4x1md/hf_loop_ant/README.md

# HF Resonant Loop Antenna

## Overview

The antenna was built to be used for shortwave listening with a Tecsun PL-660 radio receiver. Later it was used with Yaesu VX-6 handheld transceiver and with Yaesu FT-817ND for shortwave listening. The antenna is mobile and sometimes I take it to SWL on the open air.

## Construction

The antenna is built of two copper tubes. The tube used in the large loop, which forms a resonant LC circuit, is 10 mm in diameter and about 125 cm long. The small tube, which is used for coupling to the radio, is made from a 8 mm in diameter and about 28 cm long. The loops are not connected between them.

The variable capacitor is from an old AM/FM radio receiver. It has five sections: three sections of 30 pF which were used for FM band and two of about 430 pF previously used for AM reception. One 30pF section is constantly connected to the big loop while the other four can be connected using three tumbler switches (two 30pF sections are connected together). Connecting different sections makes it possible to get different maximum capacities.

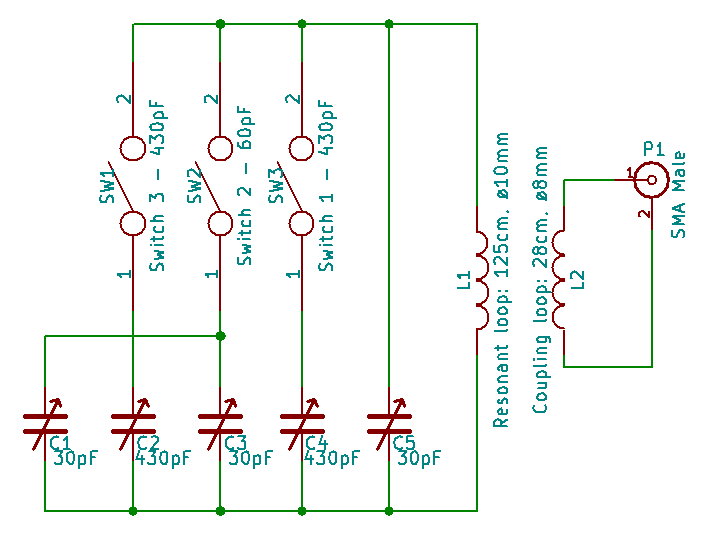
[picture p1: Images/hf_loop_schem.png]
HF Resonant Loop Schematics


## Performance

The antenna tunes from about 6.5MHz (all the capacitors connected and at are set to the full capacity) up to about 43MHz. This tuning range makes it suitable for shortwave listening on 10-40 meters bands. The antenna shows very narrow bandwidth and has to be adjusted when receiver frequency changes by about 20-30 KHz. The sensitivity is not always high and sometimes it is outperformed by a long (~10M) piece of wire.

I've never used it for transmitting because my current amateur radio license doesn't permit transmitting on HF bands.

## Photo Gallery

The first version was mounted on a plastic tube without any base to put it on.

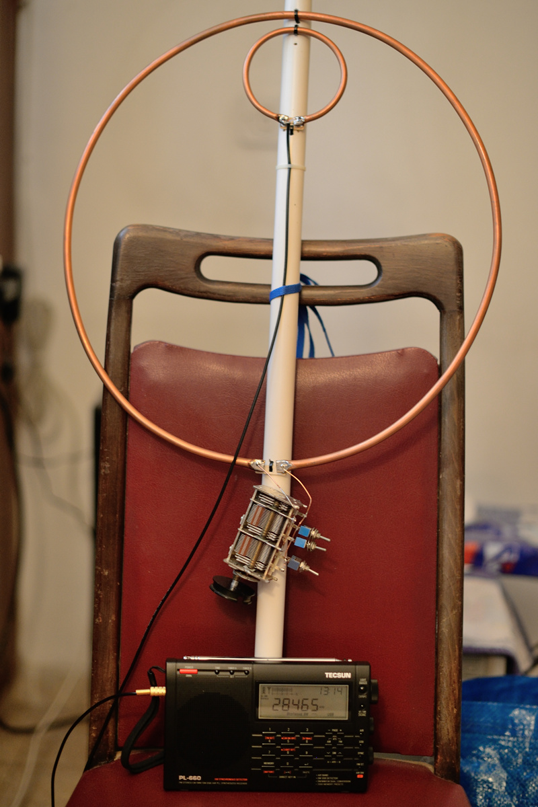
[picture p2: Images/hf_loop_01.jpg]
HF Resonant Loop


Metal tubes, variable capacitor and tumbler switches:

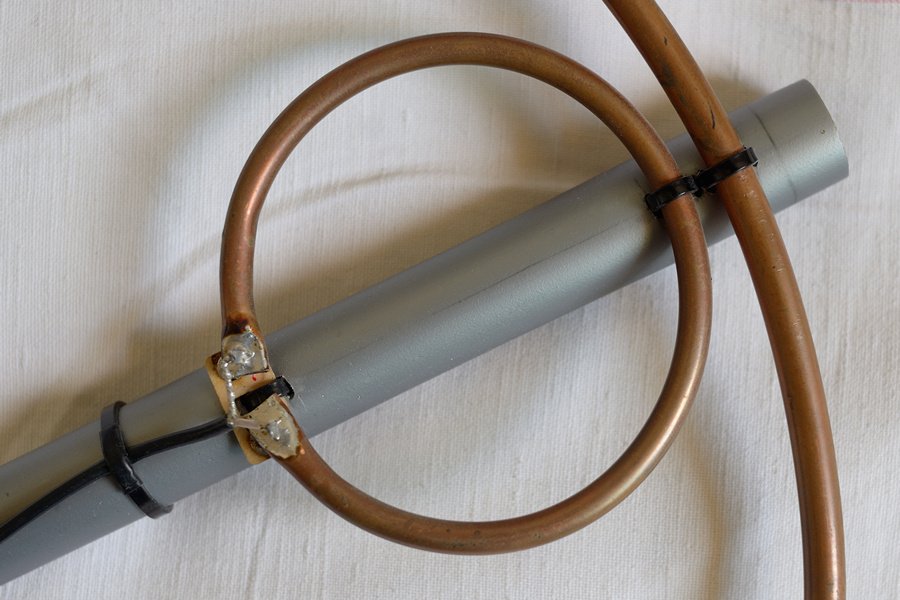
[picture p3: Images/hf_loop_02.jpg]
HF Resonant Loop


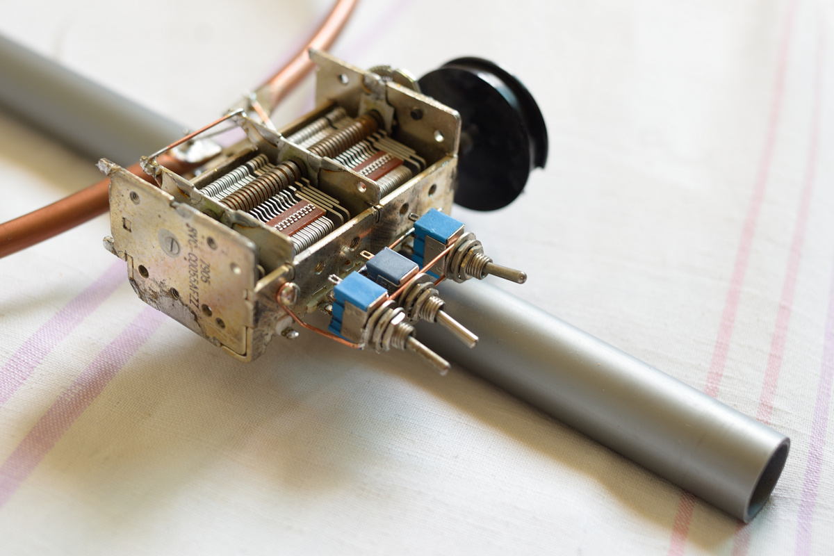
[picture p4: Images/hf_loop_03.jpg]
HF Resonant Loop


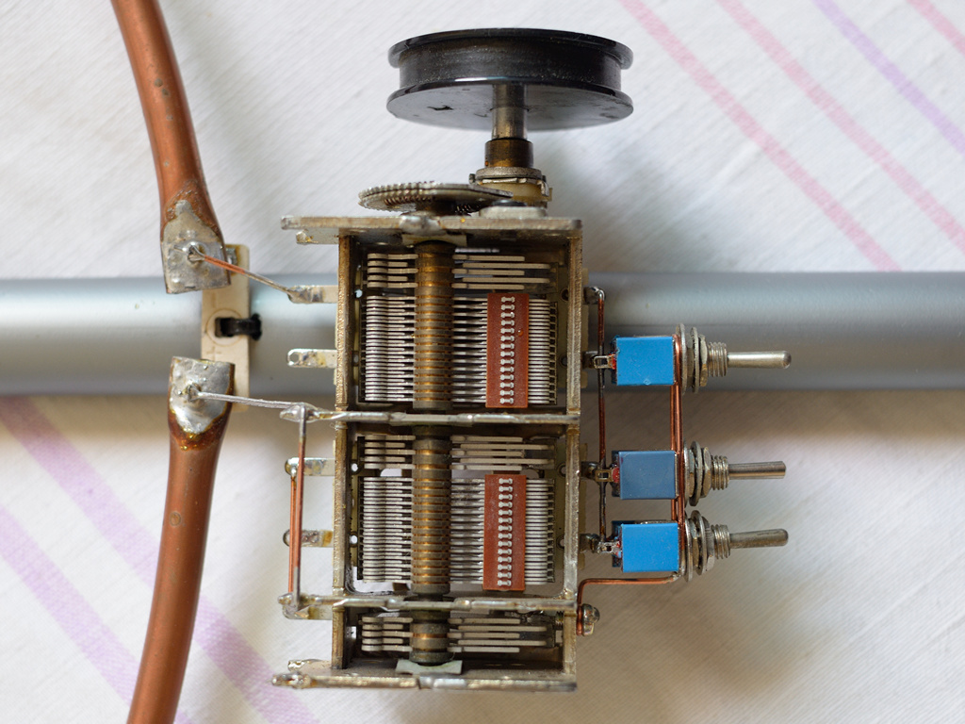
[picture p5: Images/hf_loop_04.jpg]
HF Resonant Loop


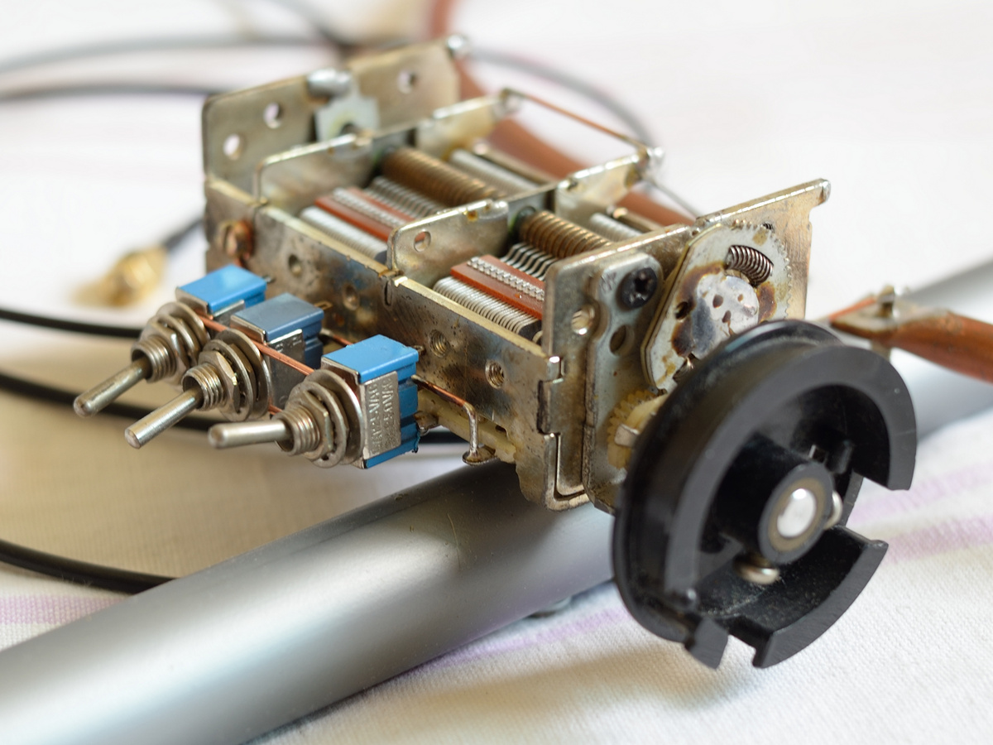
[picture p6: Images/hf_loop_05.jpg]
HF Resonant Loop


The final version is mounted on a dust pan. On the photo: antenna, Tecsun PL-660 receiver and my favourite Parker "51" fountain pen.

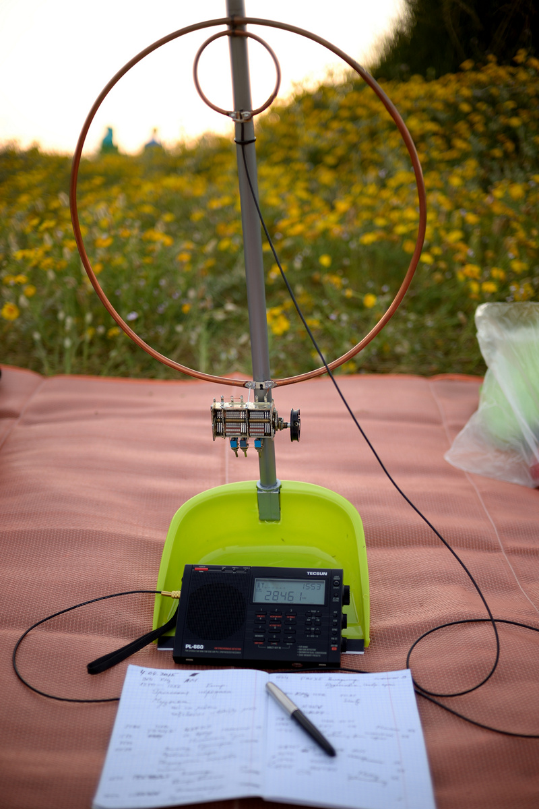
[picture p7: Images/hf_loop_06.jpg]
HF Resonant Loop


The pan is used as a base and some stones put on it make it stable.

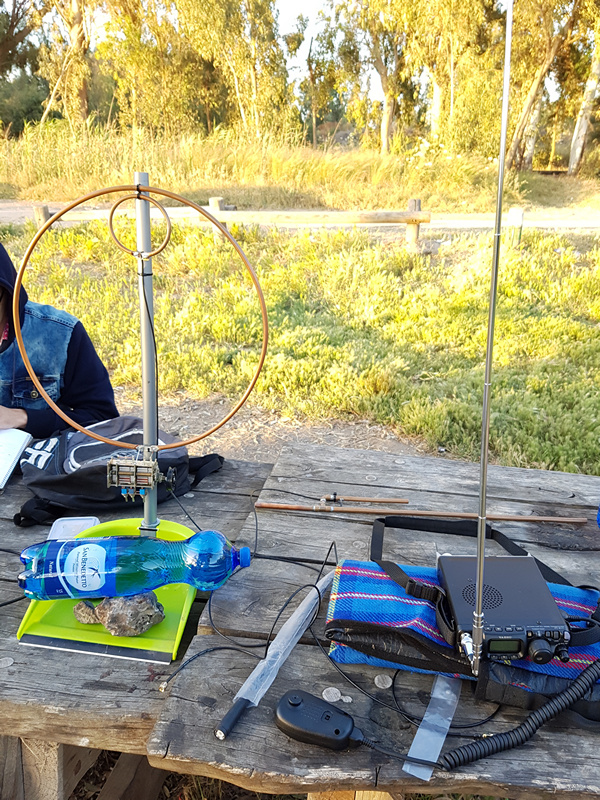
[picture p8: Images/hf_loop_07.jpg]
HF Resonant Loop


## Questions? Suggestions?
You are more than welcome to contact me with any questions, suggestions or propositions regarding this project. You can:

1. Visit [my QRZ.COM page](https://www.qrz.com/db/4X5DM)
2. Visit [my Facebook profile](https://www.facebook.com/Dima.Meln)
3. Write me an email to iosaaris =at= gmail dot com

73 de 4X5DM ex 4Z7DTF

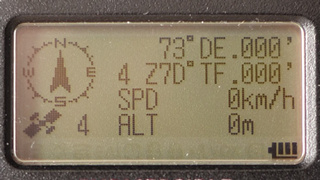
[picture p9: Images/vx8_73.jpg]
73's
