4x1md/hf_loop_ant/hf_loop_kicad/hf_loop_kicad.sch

## KiCad design hf_loop_kicad/hf_loop_kicad.sch (2016-04-30)

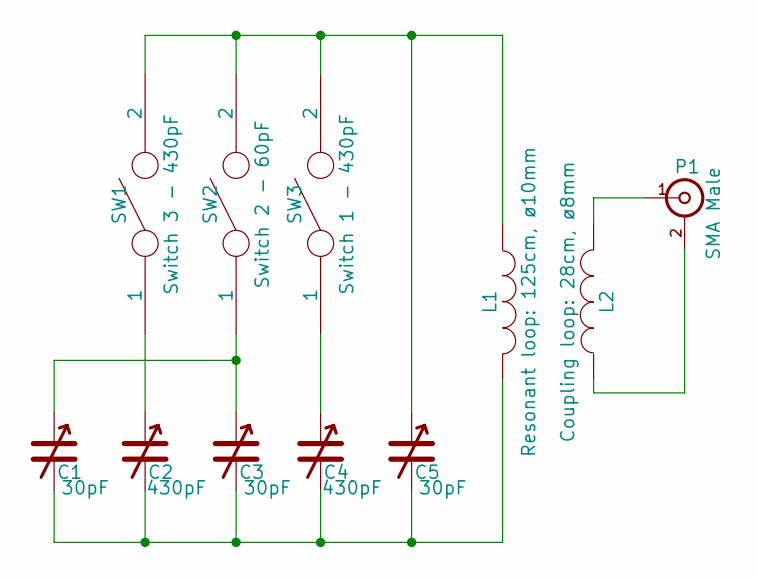
[picture p10: schematic hf_loop_kicad.sch]

Parts:
C1, C3, C5: 30pF
C2, C4: 430pF
L1: Resonant loop: 125cm, ø10mm
L2: Coupling loop: 28cm, ø8mm
P1: SMA Male
SW1: Switch 3 - 430pF
SW2: Switch 2 - 60pF
SW3: Switch 1 - 430pF

Connections:
unnamed: C1.1, C3.1, SW2.1
unnamed: C1.2, C2.2, C3.2, C4.2, C5.2, L1.2
unnamed: C2.1, SW1.1
unnamed: C4.1, SW3.1
unnamed: C5.1, L1.1, SW1.2, SW2.2, SW3.2
unnamed: L2.1, P1.2 (Ext)
unnamed: L2.2, P1.1 (In)
